cs2dsb/coffee_assistant/README.md

# coffee_assistant

## License

Free and open source software distributed under the terms of both the [MIT License][lm] and the [Apache License 2.0][la].

[lm]: LICENSE-MIT
[la]: LICENSE-APACHE
