cs2dsb/coffee_assistant/software/README.md

# Software

## scale

### Todo

*   Captive portal
*   mDNS service
*   brotli over https?

## controller

## Notes

*   [Using this dev board](https://docs.espressif.com/projects/esp-idf/en/latest/esp32/hw-reference/esp32/get-started-devkitc.html)
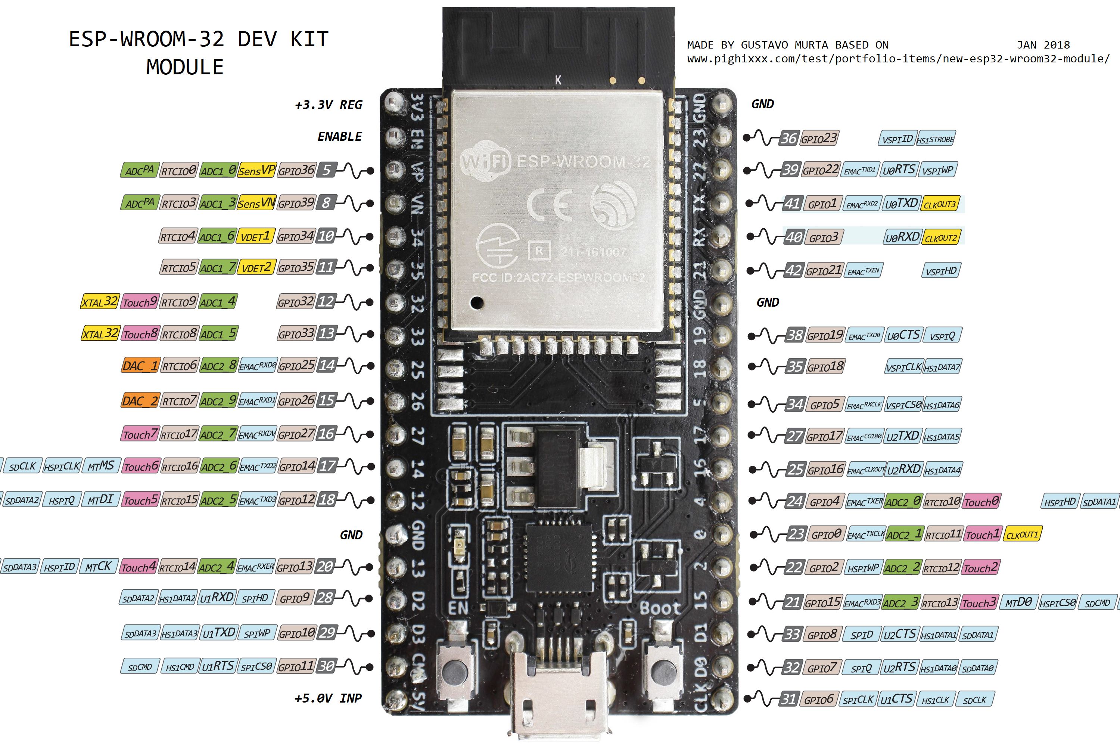
[picture p1: datasheets/esp32-devkit-c-v4.jpg]
Pinout
    
*   `make app-flash` to flash just the app
*   `make monitor` to watch serial
*   `Ctrl-]` to exit `monitor`
