cs2dsb/coffee_assistant/enclosure/CE3PRO_scale.3mf

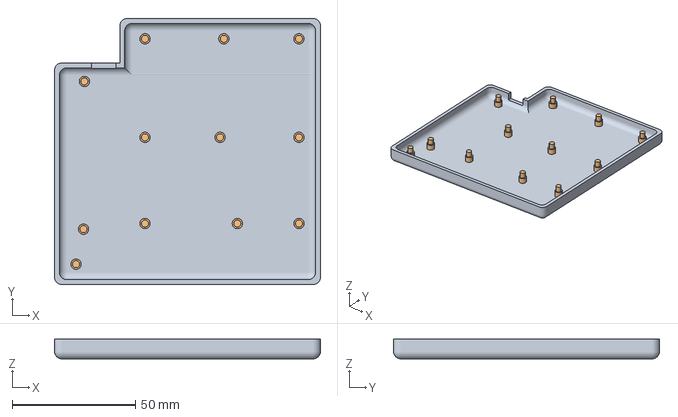
[picture p2: CAD file, 2022-09-06]
enclosure/CE3PRO_scale.3mf
108.0 x 108.0 x 8.00 mm
base.stl
posts.stl
