cs2dsb/coffee_assistant/enclosure/render/base.stl

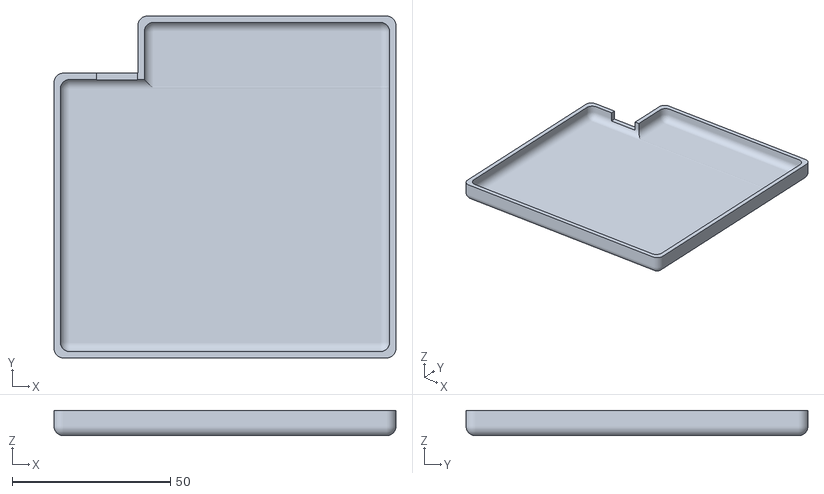
[picture p3: CAD file, 2022-09-06]
enclosure/render/base.stl
108.0 x 108.0 x 7.99
