cs2dsb/coffee_assistant/hardware/auto_weigh/NEMA_17.stl

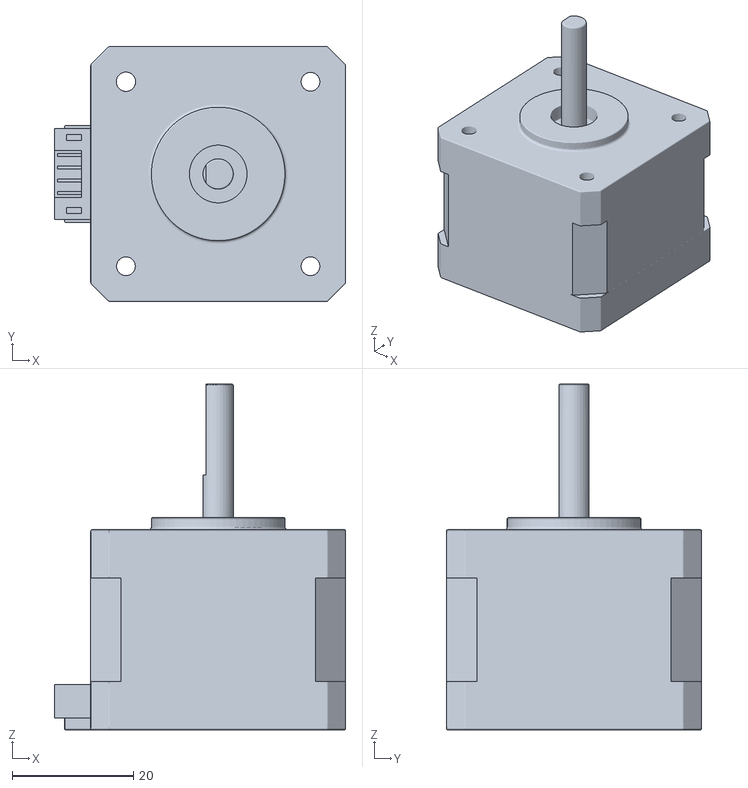
[picture p4: CAD file, 2024-04-25]
hardware/auto_weigh/NEMA_17.stl
48.0 x 42.0 x 57.0
