cs2dsb/coffee_assistant/enclosure/base_auto_weigh.stl

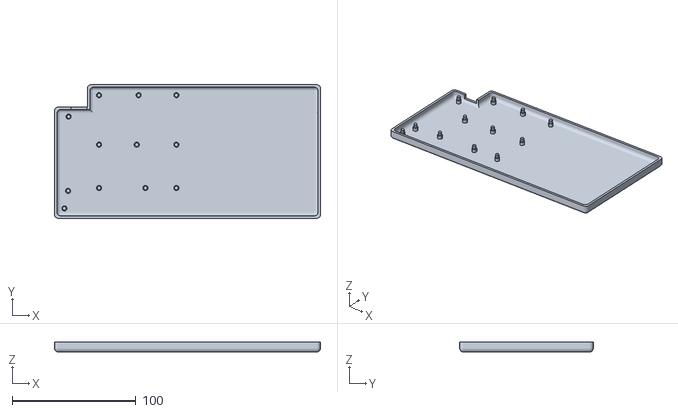
[picture p5: CAD file, 2022-09-06]
enclosure/base_auto_weigh.stl
215.0 x 108.0 x 7.99
