cs2dsb/coffee_assistant/enclosure/render/posts.stl

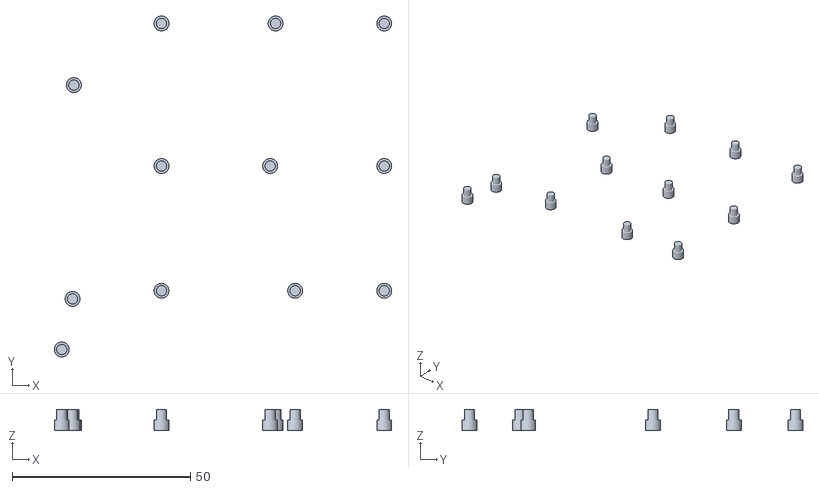
[picture p6: CAD file, 2022-09-06]
enclosure/render/posts.stl
94.7 x 95.7 x 6.00
