cs2dsb/coffee_assistant/enclosure/render/platform.stl

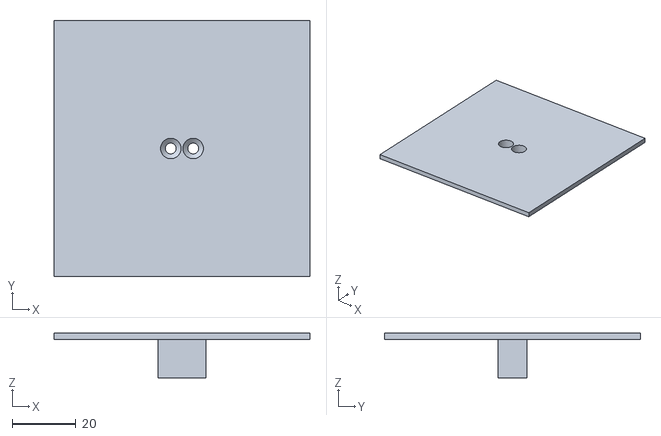
[picture p7: CAD file, 2022-09-06]
enclosure/render/platform.stl
80.0 x 80.0 x 14.0
