cs2dsb/coffee_assistant/(list of files, cad)

Other CAD files:
enclosure/posts.stl
enclosure/base.stl
hardware/auto_weigh/metric_threads.scad
hardware/auto_weigh/screw_version.scad
hardware/auto_weigh/polyround.scad
