cs2dsb/coffee_assistant/(threads)

Thread 2 (2021-07-13):

Add battery discharge prevention

cs2dsb, 2021-07-13:
Common protected packs have over charge and over current protection but no over discharge protection

Thread 3 (2021-07-13):

Replace dcdc/ldo

cs2dsb, 2021-07-13:
Current LDO is too low current for esp32
Current DCDC is moderately high quiescent current

Find a suitable part to replace them

cs2dsb, 2021-07-13:
XC6210B332MR-G
700mA out current
0.075V dropout
55uA queiescent

cs2dsb, 2021-07-13:
ME6211C33U4AG-N
500mA out current
260mV dropout
30-60uA quiescent

Thread 4 (2021-07-13):

Fix UART programming

cs2dsb, 2021-07-13:
Either add vpp cap to allow programming uart eeprom or replace it with a part that is always in uart mode

Thread 5 (2021-07-13):

Switched 3v3 and bat monitoring fets don't work

cs2dsb, 2021-07-13:
Fets are in wrong configuration and are always on
