cs2dsb/coffee_assistant/hardware/mcu/mcu.sch

## KiCad design hardware/mcu/mcu.sch (2021-07-12)

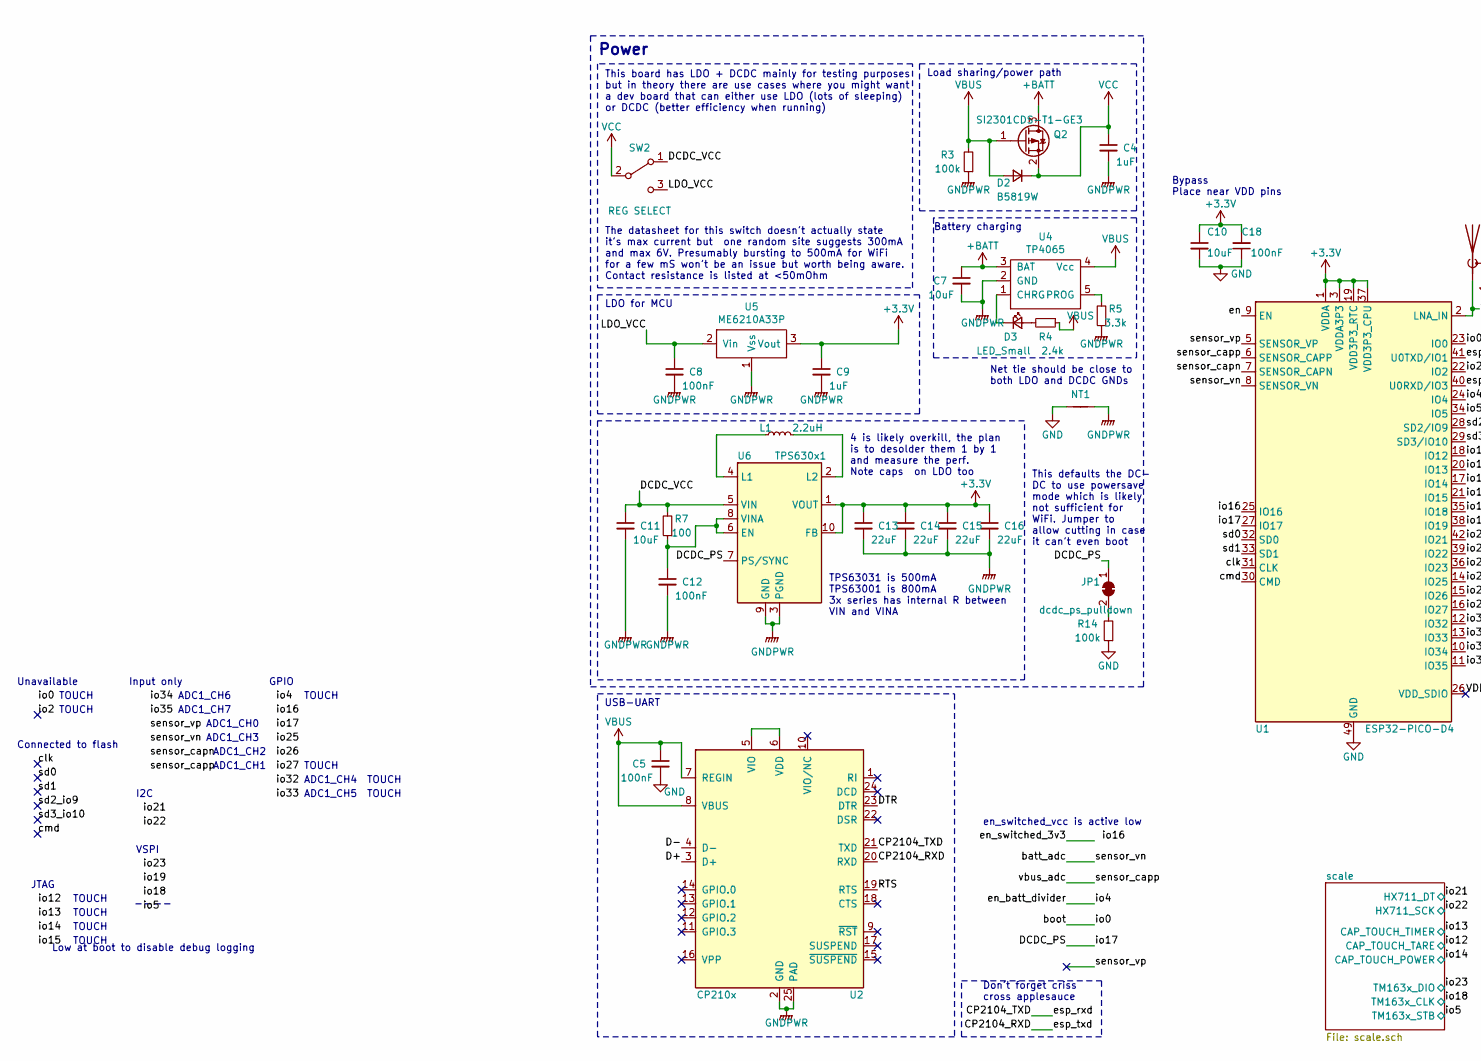
[picture p8: schematic mcu.sch, part in row 1, column 1]

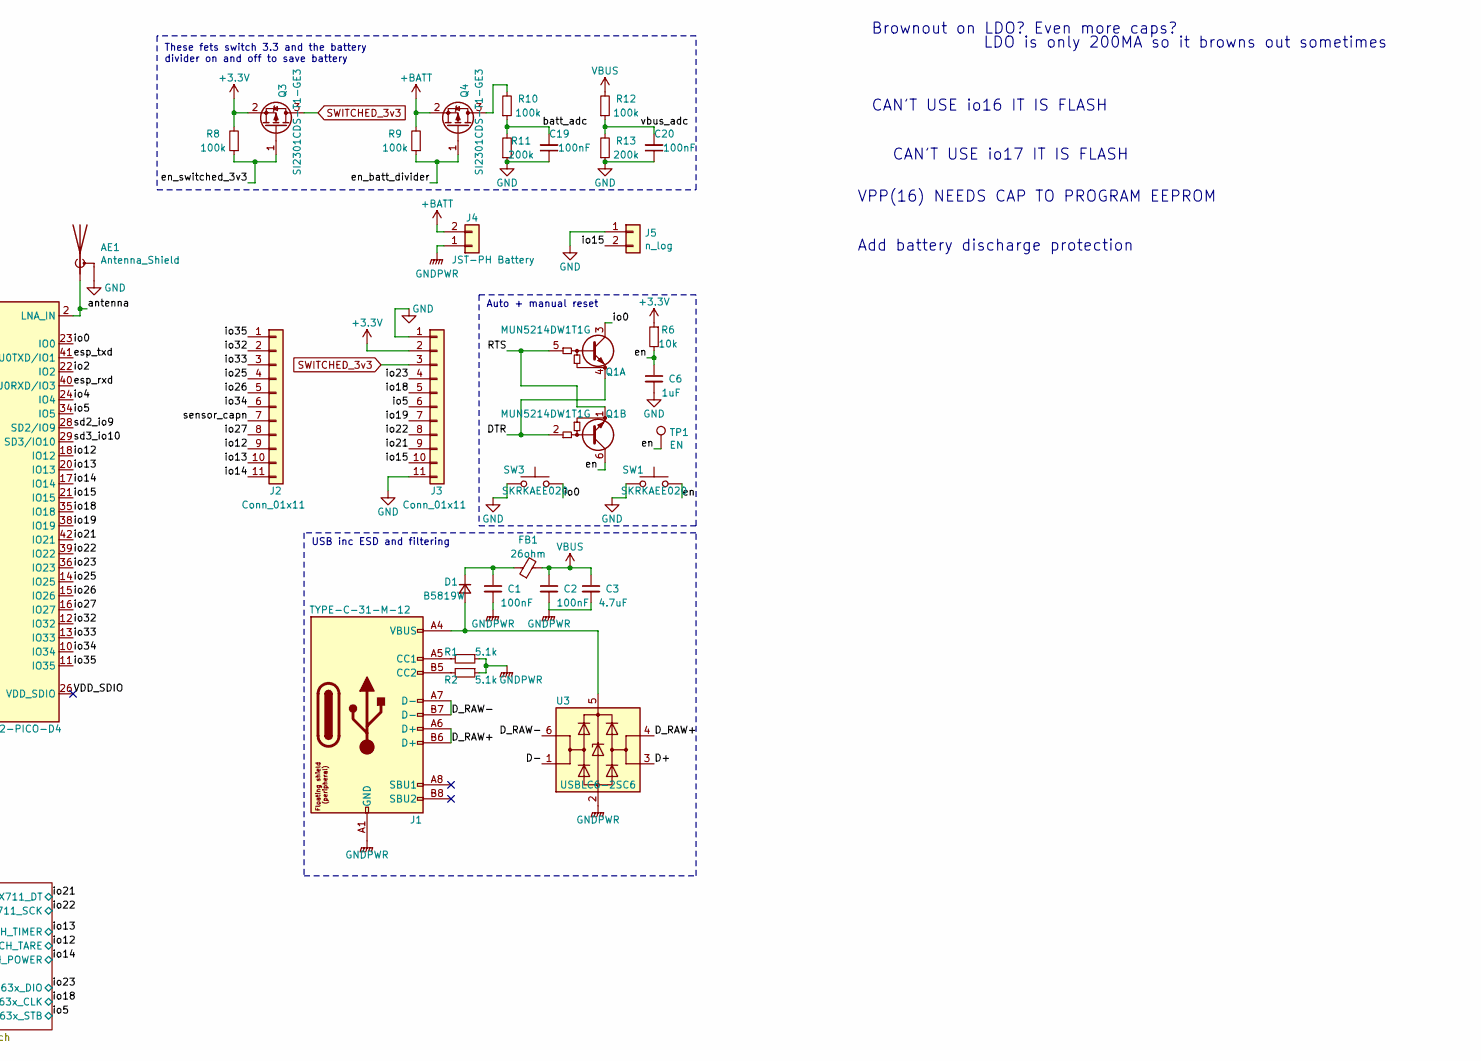
[picture p9: schematic mcu.sch, part in row 1, column 2]

Parts:
AE1: Antenna_Shield; Texas_SWRA117D_2.4GHz_Right
C1, C2, C5, C8, C12, C18, C19, C20: 100nF; C_0402_1005Metric; Part Number CL05B104KO5NNNC; LCSC Part Number C1525
C3: 4.7uF; C_0402_1005Metric; Part Number CL05A475MP5NRNC; LCSC Part Number C23733
C4, C6, C9: 1uF; C_0402_1005Metric; Part Number CL05A105KA5NQNC; LCSC Part Number C52923
C7, C10, C11: 10uF; C_0402_1005Metric; Part Number CL05A106MQ5NUNC; LCSC Part Number C15525
C13, C14, C15, C16: 22uF; C_0603_1608Metric; Part Number CL10A226MQ8NRNC; LCSC Part Number C59461
D1, D2: B5819W; D_SOD-123; Part Number B5819W; LCSC Part Number C8598
D3: LED_Small; LED_0603_1608Metric; Part Number 19-213/Y2C-CQ2R2L/3T(CY); LCSC Part Number C72038
FB1: 26ohm; L_0402_1005Metric; Part Number CBG100505U260T; LCSC Part Number C668229
J1: TYPE-C-31-M-12; Part Number TYPE-C-31-M-12; LCSC Part Number C165948
J2, J3: Conn_01x11; PinHeader_1x11_P2.54mm_Vertical
J4: JST-PH Battery; JST_PH_S2B-PH-K_1x02_P2.00mm_Horizontal; Part Number A2001WR-2P; LCSC Part Number C225207
J5: n_log; PinHeader_1x02_P2.54mm_Vertical
JP1: dcdc_ps_pulldown; SolderJumper-2_P1.3mm_Bridged_RoundedPad1.0x1.5mm
L1: 2.2uH; L_Taiyo-Yuden_NR-30xx; Part Number FNR3015S2R2MT; LCSC Part Number C167747
NT1: GND-GNDPWR; NetTie-2_JLC_Tolerances_GND
Q1: MUN5214DW1T1G; SOT-363_SC-70-6; Part Number MUN5214DW1T1G; LCSC Part Number C94403
Q2, Q3, Q4: SI2301CDS-T1-GE3; SOT-23; Part Number SI2301CDS-T1-GE3; LCSC Part Number C10487
R1, R2: 5.1k; R_0402_1005Metric; Part Number 0402WGF5101TCE; LCSC Part Number C25905
R3, R8, R9, R10, R12, R14: 100k; R_0402_1005Metric; Part Number 0402WGF1003TCE; LCSC Part Number C25741
R4: 2.4k; R_0402_1005Metric; Part Number 0402WGF2401TCE; LCSC Part Number C25882
R5: 3.3k; R_0402_1005Metric; Part Number 0402WGF3301TCE; LCSC Part Number C25890
R6: 10k; R_0402_1005Metric; Part Number 0402WGF1002TCE; LCSC Part Number C25744
R7: 100; R_0402_1005Metric; Part Number 0402WGF1000TCE; LCSC Part Number C25076
R11, R13: 200k; R_0402_1005Metric; Part Number 0402WGF2003TCE; LCSC Part Number C25764
SW1, SW3: SKRKAEE020; SW_Push_SPST_NO_Alps_SKRK; Part Number SKRKAEE020; LCSC Part Number C115357
SW2: REG SELECT; SPDT_Switch_K3-1235S-F1_WITH_BRIDGES; Part Number K3-1235S-F1; LCSC Part Number C92660
TP1: EN; TestPoint_Pad_D1.0mm
U1: ESP32-PICO-D4; QFN-48-1EP_7x7mm_P0.5mm_EP4.6x4.6mm; Part Number ESP32-PICO-D4; LCSC Part Number C193707
U2: CP210x; QFN-24-1EP_4x4mm_P0.5mm_EP2.6x2.6mm; Part Number CP2105-F01-GMR; LCSC Part Number C109102
U3: USBLC6-2SC6; SOT-23-6; Part Number TPUSBLC6-2SC6; LCSC Part Number C558442
U4: TP4065; SOT-23-5; Part Number TP4054; LCSC Part Number C32574
U5: ME6210A33P; SOT-89-3; Part Number ME6210A33P; LCSC Part Number C85233
U6: TPS630x1; TPS63001_vson_10_solid_ep; Part Number TPS63031DSKR; LCSC Part Number C15516

Connections:
+3.3V: C9.1, C10.1, C13.1, C14.1, C15.1, C16.1, C18.2, J3.2, Q3.2 (S), R6.1, R8.2, U1.1 (VDDA), U1.3 (VDDA3P3), U1.4 (VDDA3P3), U1.19 (VDD3P3_RTC), U1.37 (VDD3P3_CPU), U1.43 (VDDA), U1.46 (VDDA), U5.3 (Vout), U6.1 (VOUT), U6.10 (FB)
+BATT: C7.1, J4.2, Q2.3 (D), Q4.2 (S), R9.2, U4.3 (BAT)
CP2104_RXD: U1.41 (U0TXD/IO1), U2.20 (RXD)
CP2104_TXD: U1.40 (U0RXD/IO3), U2.21 (TXD)
D+: U2.3 (D+), U3.3 (I/O2)
D-: U2.4 (D-), U3.1 (I/O1)
DCDC_PS: JP1.1 (A), U1.27 (IO17), U6.7 (PS/SYNC)
DCDC_VCC: C11.1, R7.2, SW2.1 (A), U6.5 (VIN)
DTR: Q1.2 (B1), Q1.4 (E1), U2.23 (DTR)
D_RAW+: J1.A6 (D+), J1.B6 (D+), U3.4 (I/O2)
D_RAW-: J1.A7 (D-), J1.B7 (D-), U3.6 (I/O1)
GND: AE1.2 (Shield), C5.2, C6.2, C10.2, C18.1, C19.1, C20.1, J3.1, J3.11, J5.1, NT1.1, R11.1, R13.1, R14.1, SW1.1, SW3.1, U1.49 (GND)
GNDPWR: C1.2, C2.2, C3.2, C4.2, C7.2, C8.2, C9.2, C11.2, C12.2, C13.2, C14.2, C15.2, C16.2, J1.A1 (GND), J1.A12 (GND), J1.B1 (GND), J1.B12 (GND), J4.1, NT1.2, R1.1, R2.1, R3.1, R5.1, U2.2 (GND), U2.25 (PAD), U3.2 (GND), U4.2 (GND), U5.1 (Vss), U6.3 (PGND), U6.9 (GND), U6.11 (PGND)
LDO_VCC: C8.1, SW2.3 (C), U5.2 (Vin)
unnamed: C1.1, D1.1 (K), FB1.1
unnamed: C12.1, R7.1, U6.6 (EN), U6.8 (VINA)
unnamed: D1.2 (A), J1.A4 (VBUS), J1.A9 (VBUS), J1.B4 (VBUS), J1.B9 (VBUS), U3.5 (VBUS)
unnamed: D3.1 (K), U4.1 (CHRG)
unnamed: D3.2 (A), R4.2
unnamed: J1.A5 (CC1), R1.2
unnamed: J1.B5 (CC2), R2.2
unnamed: JP1.2 (B), R14.2
unnamed: L1.1, U6.4 (L1)
unnamed: L1.2, U6.2 (L2)
unnamed: Q4.3 (D), R10.2
unnamed: R5.2, U4.5 (PROG)
unnamed: U2.5 (VIO), U2.6 (VDD)
RTS: Q1.1 (E1), Q1.5 (B1), U2.19 (RTS)
SWITCHED_3v3: J3.3, Q3.3 (D)
VBUS: C2.1, C3.1, C5.1, D2.2 (A), FB1.2, Q2.1 (G), R3.2, R4.1, R12.2, U2.7 (REGIN), U2.8 (VBUS), U4.4 (Vcc)
VCC: C4.1, D2.1 (K), Q2.2 (S), SW2.2 (B)
VDD_SDIO: U1.26 (VDD_SDIO)
antenna: AE1.1 (A), U1.2 (LNA_IN)
batt_adc: C19.2, R10.1, R11.2, U1.8 (SENSOR_VN)
boot: Q1.3 (C1), SW3.2, U1.23 (IO0)
clk: U1.31 (CLK)
cmd: U1.30 (CMD)
en: C6.1, Q1.6 (C1), R6.2, SW1.2, TP1.1, U1.9 (EN)
en_batt_divider: Q4.1 (G), R9.1, U1.24 (IO4)
en_switched_3v3: Q3.1 (G), R8.1
io2: U1.22 (IO2)
io5: J3.6, U1.34 (IO5)
io12: J2.9, U1.18 (IO12)
io13: J2.10, U1.20 (IO13)
io14: J2.11, U1.17 (IO14)
io15: J3.10, J5.2, U1.21 (IO15)
io16: U1.25 (IO16)
io18: J3.5, U1.35 (IO18)
io19: J3.7, U1.38 (IO19)
io21: J3.9, U1.42 (IO21)
io22: J3.8, U1.39 (IO22)
io23: J3.4, U1.36 (IO23)
io25: J2.4, U1.14 (IO25)
io26: J2.5, U1.15 (IO26)
io27: J2.8, U1.16 (IO27)
io32: J2.2, U1.12 (IO32)
io33: J2.3, U1.13 (IO33)
io34: J2.6, U1.10 (IO34)
io35: J2.1, U1.11 (IO35)
sd0: U1.32 (SD0)
sd1: U1.33 (SD1)
sd2_io9: U1.28 (SD2/IO9)
sd3_io10: U1.29 (SD3/IO10)
sensor_capn: J2.7, U1.7 (SENSOR_CAPN)
sensor_capp: C20.2, R12.1, R13.2, U1.6 (SENSOR_CAPP)
sensor_vp: U1.5 (SENSOR_VP)

Notes on the sheet:
USB inc ESD and filtering
Load sharing/power path
Auto + manual reset
Battery charging
LDO for MCU
The datasheet for this switch doesn't actually state it's max current but one random site suggests 300mA and max 6V. Presumably bursting to 500mA for WiFi for a few mS won't be an issue but worth being aware. Contact resistance is listed at <50mOhm
TPS63031 is 500mA TPS63001 is 800mA 3x series has internal R between VIN and VINA
4 is likely overkill, the plan is to desolder them 1 by 1 and measure the perf. Note caps on LDO too
Net tie should be close to both LDO and DCDC GNDs
This board has LDO + DCDC mainly for testing purposes but in theory there are use cases where you might want a dev board that can either use LDO (lots of sleeping) or DCDC (better efficiency when running)
Power
Don't forget criss cross applesauce
en_switched_vcc is active low
These fets switch 3.3 and the battery divider on and off to save battery
Bypass Place near VDD pins
Unavailable
Input only
Connected to flash
Low at boot to disable debug logging
I2C
VSPI
JTAG
GPIO
ADC1_CH4
ADC1_CH5
ADC1_CH6
ADC1_CH7
ADC1_CH0
ADC1_CH3
TOUCH
ADC1_CH1
ADC1_CH2
USB-UART
This defaults the DC- DC to use powersave mode which is likely not sufficient for WiFi. Jumper to allow cutting in case it can't even boot
CAN'T USE io16 IT IS FLASH
CAN'T USE io17 IT IS FLASH
VPP(16) NEEDS CAP TO PROGRAM EEPROM
Brownout on LDO? Even more caps?
LDO is only 200MA so it browns out sometimes
Add battery discharge protection
