cs2dsb/coffee_assistant/hardware/mcu/scale.sch

## KiCad design hardware/mcu/scale.sch (2021-04-30)

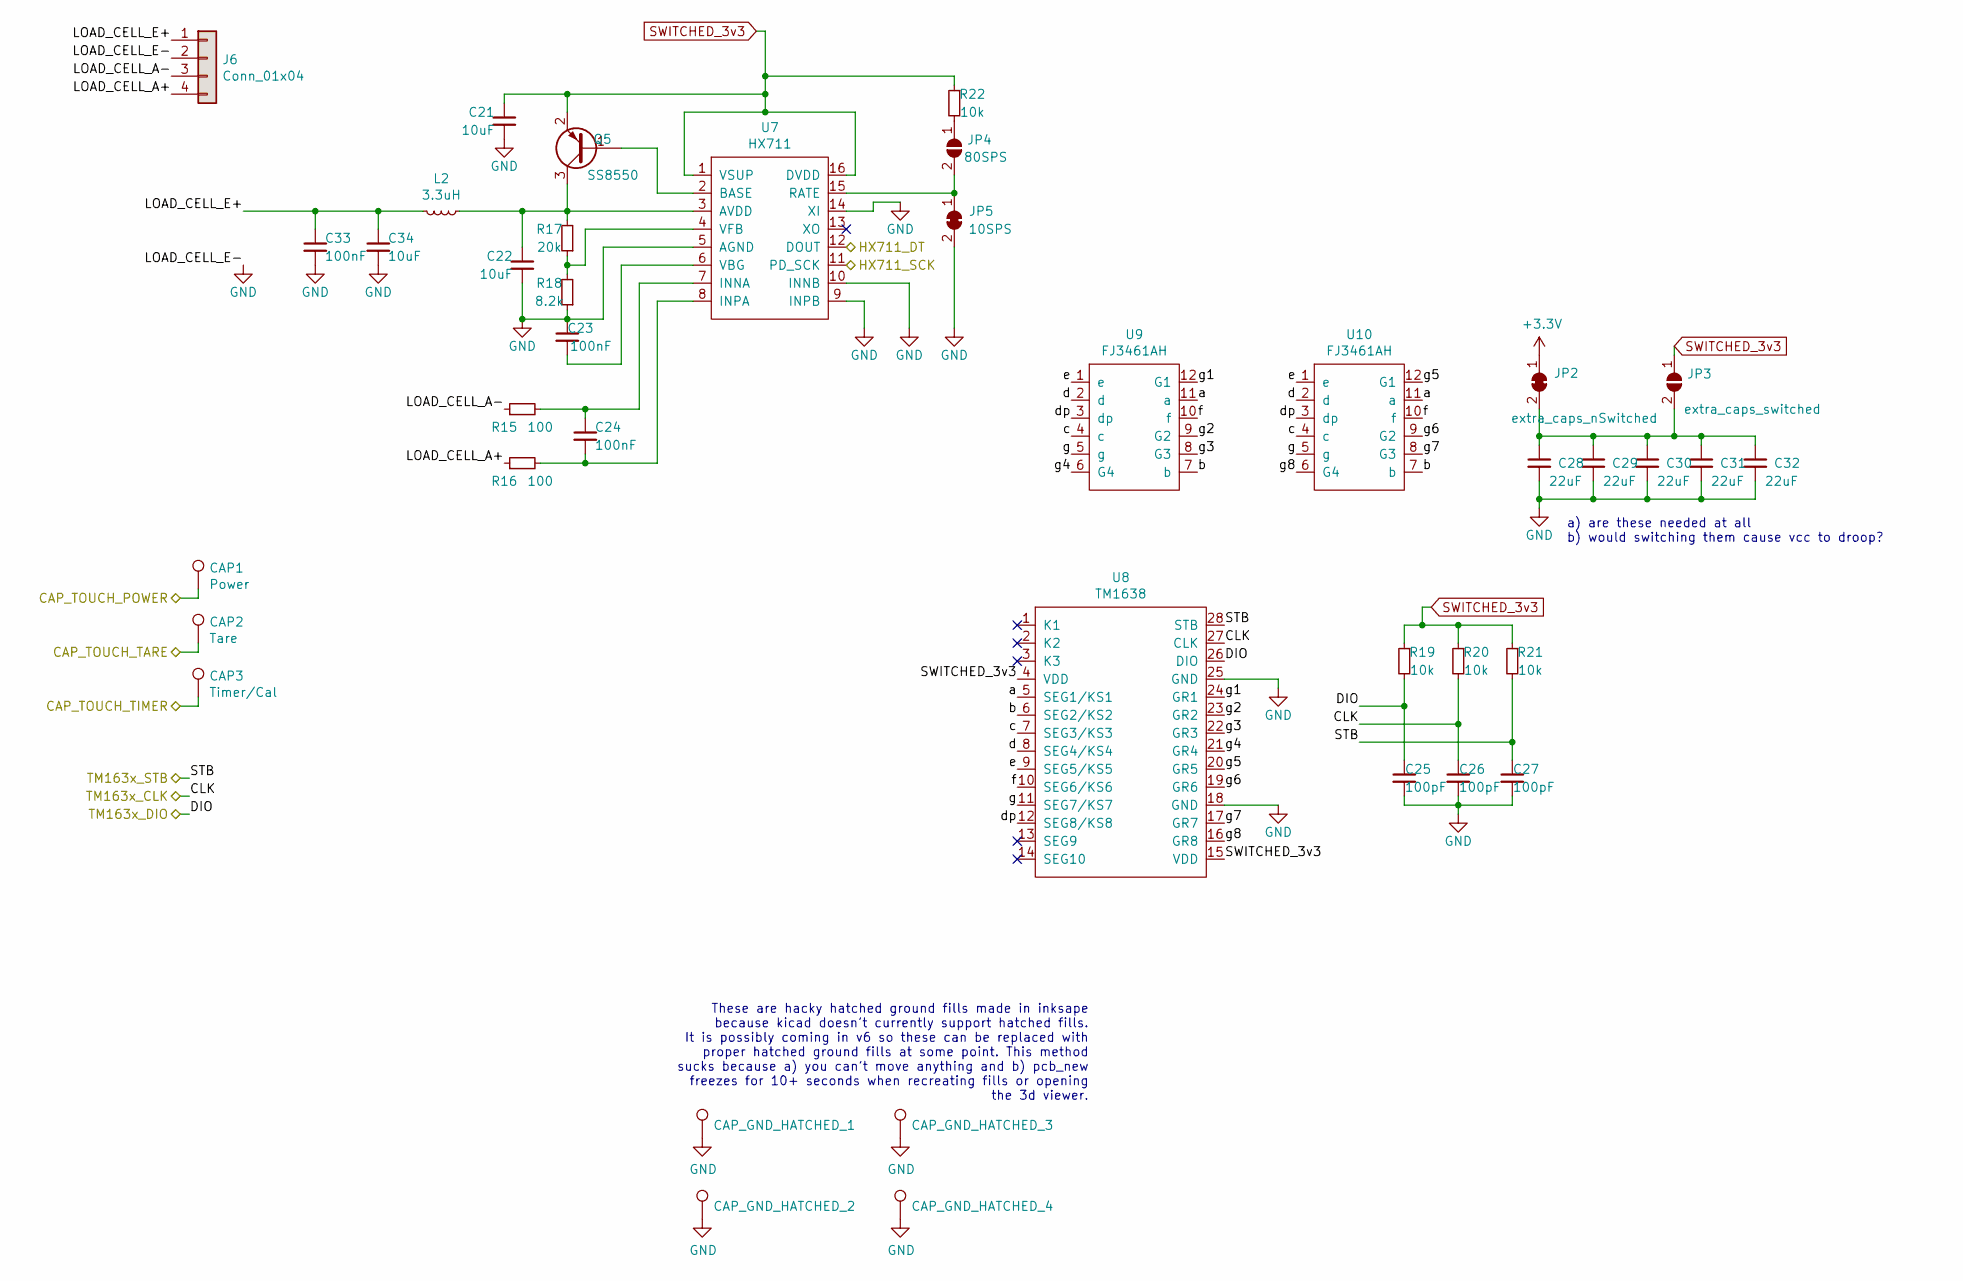
[picture p10: schematic scale.sch]

Parts:
C21, C22, C34: 10uF; C_0402_1005Metric; Part Number CL05A106MQ5NUNC; LCSC Part Number C15525
C23, C24, C33: 100nF; C_0402_1005Metric; Part Number CL05B104KO5NNNC; LCSC Part Number C1525
C25, C26, C27: 100pF; C_0402_1005Metric; Part Number 0402CG101J500NT; LCSC Part Number C1546
C28, C29, C30, C31, C32: 22uF; C_0603_1608Metric; Part Number CL10A226MQ8NRNC; LCSC Part Number C59461
CAP1: Power; CapTouch_12mm
CAP2: Tare; CapTouch_12mm
CAP3: Timer/Cal; CapTouch_12mm
CAP_GND_HATCHED_1: Cap sense grid ground; cap_gnd_1_hatched
CAP_GND_HATCHED_2: Cap sense grid ground; cap_gnd_2_hatched
CAP_GND_HATCHED_3: Cap sense grid ground; cap_gnd_3_hatched
CAP_GND_HATCHED_4: Cap sense grid ground; cap_gnd_4_hatched
J6: Conn_01x04; PinHeader_1x04_P2.54mm_Vertical
JP2: extra_caps_nSwitched; SolderJumper-2_P1.3mm_Bridged_RoundedPad1.0x1.5mm
JP3: extra_caps_switched; SolderJumper-2_P1.3mm_Open_RoundedPad1.0x1.5mm
JP4: 80SPS; SolderJumper-2_P1.3mm_Open_RoundedPad1.0x1.5mm
JP5: 10SPS; SolderJumper-2_P1.3mm_Bridged_RoundedPad1.0x1.5mm
L2: 3.3uH; L_0805_2012Metric; Part Number SDFL2012Q3R3KTF; LCSC Part Number C51725
Q5: SS8550; SOT-23; Part Number SS8550; LCSC Part Number C8542
R15, R16: 100; R_0402_1005Metric; Part Number 0402WGF1000TCE; LCSC Part Number C25076
R17: 20k; R_0402_1005Metric; Part Number 0402WGF2002TCE; LCSC Part Number C25765
R18: 8.2k; R_0402_1005Metric; Part Number 0402WGF8201TCE; LCSC Part Number C25924
R19, R20, R21, R22: 10k; R_0402_1005Metric; Part Number 0402WGF1002TCE; LCSC Part Number C25744
U7: HX711; SOP-16_3.9x9.9mm_P1.27mm; Part Number HX711; LCSC Part Number C43656
U8: TM1638; SOIC-28W_7.5x17.9mm_P1.27mm; Part Number TM1638; LCSC Part Number C19187
U9, U10: FJ3461AH; Part Number FJ3461AH; LCSC Part Number C10708

Connections:
+3.3V: JP2.1 (A)
CAP_TOUCH_POWER: CAP1.1
CAP_TOUCH_TARE: CAP2.1
CAP_TOUCH_TIMER: CAP3.1
CLK: C26.1, R20.2, U8.27 (CLK)
DIO: C25.1, R19.2, U8.26 (DIO)
GND: C21.2, C22.2, C23.1, C25.2, C26.2, C27.2, C28.2, C29.2, C30.2, C31.2, C32.2, C33.2, C34.2, CAP_GND_HATCHED_1.1, CAP_GND_HATCHED_2.1, CAP_GND_HATCHED_3.1, CAP_GND_HATCHED_4.1, J6.2, JP5.2 (B), R18.1, U7.5 (AGND), U7.9 (INPB), U7.10 (INNB), U7.14 (XI), U8.18 (GND), U8.25 (GND)
HX711_DT: U7.12 (DOUT)
HX711_SCK: U7.11 (PD_SCK)
LOAD_CELL_A+: J6.4, R16.1
LOAD_CELL_A-: J6.3, R15.1
LOAD_CELL_E+: C33.1, C34.1, J6.1, L2.2
unnamed: C22.1, L2.1, Q5.3 (C), R17.2, U7.3 (AVDD)
unnamed: C23.2, U7.6 (VBG)
unnamed: C24.1, R15.2, U7.7 (INNA)
unnamed: C24.2, R16.2, U7.8 (INPA)
unnamed: C28.1, C29.1, C30.1, C31.1, C32.1, JP2.2 (B), JP3.2 (B)
unnamed: JP4.1 (A), R22.2
unnamed: JP4.2 (B), JP5.1 (A), U7.15 (RATE)
unnamed: Q5.1 (B), U7.2 (BASE)
unnamed: R17.1, R18.2, U7.4 (VFB)
STB: C27.1, R21.2, U8.28 (STB)
SWITCHED_3v3: C21.1, JP3.1 (A), Q5.2 (E), R19.1, R20.1, R21.1, R22.1, U7.1 (VSUP), U7.16 (DVDD), U8.4 (VDD), U8.15 (VDD)
a: U8.5 (SEG1/KS1), U9.11 (a), U10.11 (a)
b: U8.6 (SEG2/KS2), U9.7 (b), U10.7 (b)
c: U8.7 (SEG3/KS3), U9.4 (c), U10.4 (c)
d: U8.8 (SEG4/KS4), U9.2 (d), U10.2 (d)
dp: U8.12 (SEG8/KS8), U9.3 (dp), U10.3 (dp)
e: U8.9 (SEG5/KS5), U9.1 (e), U10.1 (e)
f: U8.10 (SEG6/KS6), U9.10 (f), U10.10 (f)
g: U8.11 (SEG7/KS7), U9.5 (g), U10.5 (g)
g1: U8.24 (GR1), U9.12 (G1)
g2: U8.23 (GR2), U9.9 (G2)
g3: U8.22 (GR3), U9.8 (G3)
g4: U8.21 (GR4), U9.6 (G4)
g5: U8.20 (GR5), U10.12 (G1)
g6: U8.19 (GR6), U10.9 (G2)
g7: U8.17 (GR7), U10.8 (G3)
g8: U8.16 (GR8), U10.6 (G4)

Notes on the sheet:
These are hacky hatched ground fills made in inksape because kicad doesn't currently support hatched fills. It is possibly coming in v6 so these can be replaced with proper hatched ground fills at some point. This method sucks because a) you can't move anything and b) pcb_new freezes for 10+ second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
a) are these needed at all b) would switching them cause vcc to droop?
