cs2dsb/coffee_assistant/software/scale/board.h

#define PIN_TOUCH_POWER                 14
#define PIN_TOUCH_TARE                  12
#define PIN_TOUCH_TIMER                 13

#define PIN_HX711_DT                    21
#define PIN_HX711_SCK                   22

#define PIN_TM1638_STB                  5
#define PIN_TM1638_CLK                  18
#define PIN_TM1638_DIO                  23

#define PIN_EN_BATT_DIVIDER             4
#define PIN_ANALOG_BATT                 39 //ADC1_CH3

#define PIN_ANALOG_VBUS                 37 //ADC1_CH1

#define BATT_DIVIDER_R1                 100000
#define BATT_DIVIDER_R2                 200000
