cs2dsb/coffee_assistant/(commit log)

2021-03-26 Swapped esp-idf out for arduino-cli due to library availability
2021-03-28 Switched SPIFFS to LITTLEFS
    Added nicer handler registration method that checks if the file exists and returns 404 instead of panicing
2021-03-30 Tare & Calibrate buttons on graph page
2021-03-31 Hooked up tare and cal buttons
2021-04-10 capsense test
    battery life test
2021-04-21 Mostly finished MCU board
    [mcu.kicad_pcb, mcu.sch]
2021-04-30 Prototype scale v0.1
    [mcu.kicad_pcb, mcu.sch, scale.sch]
2021-07-04 Split scale code up into multiple files
    Swapped PubSubClient out in favour of the esp-idf mqtt client because it supports QoS 1
    ADC calibration
    Powersaving tweaks
    [bat-test.ino, board.h, config.h, esp-now-bridge-test.ino]
2021-07-12 Working scale + controller
    [mcu.kicad_pcb, mcu.sch]
2022-09-06 Auto weigh stuff
    [CE3PRO_scale.3mf, base.stl, base_auto_weigh.stl, hull.scad, mcu.kicad_pcb, metric_threads.scad, platform.stl, posts.stl]
2024-01-22 Disabled the calibration button since it was getting triggered by moisture and messing the scale up
2024-04-25 Added 3d printing files for auto_weigh
    [NEMA_17.stl, gears.scad, main.scad, metric_threads.scad, polyround.scad, revolve2.scad, screw_version.scad]
